jobitjoseph/USB-C-Power-Meter/Hardware/production/bom.csv

Designator | Footprint | Quantity | Value | LCSC Part #
C1, C2, C3, C4, C7, C8, C9 | 0402 | 7 | 100nF
C10, C11 | 0603 | 2 | 4.7uF
C5, C6 | 0402 | 2 | 1uF
J1 | USB_C_Plug_Molex_105444 | 1 | UP32-C-F-G-FL-1-P24 | C42453853
J2 | USB_C_Receptacle_HRO_TYPE-C-31-M-12 | 1 | USB_C_Receptacle_USB2.0_16P
Q1 | SOT-23 | 1 | SS8050
R1 | 0402 | 1 | 5.1K
R10, R11, R12, R13, R14, R15, R5, R6, R8 | 0402 | 9 | 10K
R2, R3, R7 | 0402 | 3 | 4.7K
R4 | 2512 | 1 | 10m
R9 | 0603 | 1 | 10R
SW1, SW2, SW3, SW4 | Untitled | 4 | ~
TP1, TP2, TP3, TP4, TP5 | TestPoint_Pad_D1.0mm | 5 | TestPoint_Small
U1 | VDFN10_9QX_MCH | 1 | PAC1811T-2E/9Q
U2 | SOT_223_5L_MCH | 1 | MCP1781-3302H/DB
U3 | OLED-SMD_ST7735S | 1 | N096-1608TBBIG11-H13
U4 | QFN48_7X7MC_MCH | 1 | ATSAMD21G18A-MFT
Y1 | Crystal_SMD_MicroCrystal_CM9V-T1A-2Pin_1.6x1.0mm_HandSoldering | 1 | 32.768KHz
