jobitjoseph/USB-C-Power-Meter/STL/Button.stl

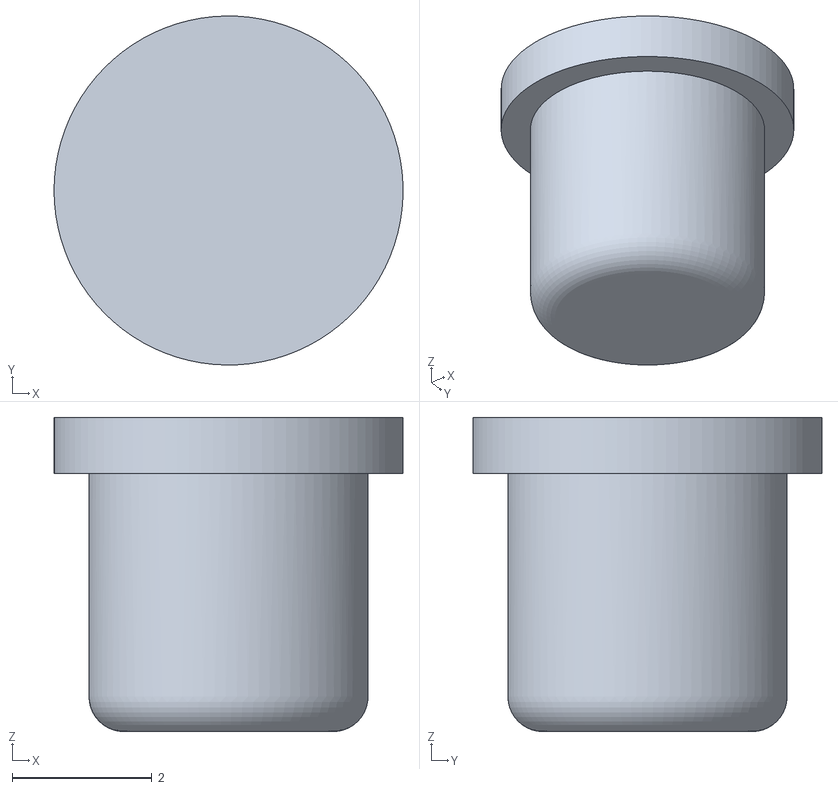
[picture p1: CAD file, 2026-10-21]
STL/Button.stl
5.00 x 5.00 x 4.50
