jobitjoseph/USB-C-Power-Meter/STL/Enclosure_Bottom.stl

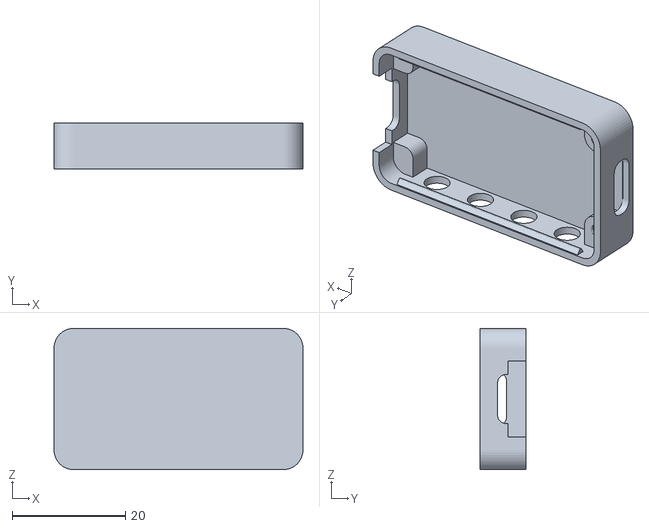
[picture p2: CAD file, 2026-10-21]
STL/Enclosure_Bottom.stl
44.0 x 8.09 x 25.0
