jobitjoseph/USB-C-Power-Meter/STL/Enclosure_Top.stl

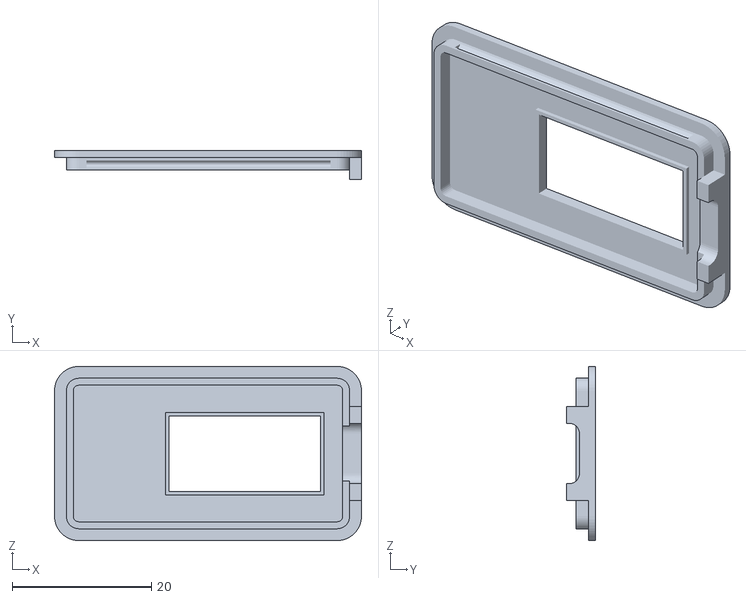
[picture p3: CAD file, 2026-10-21]
STL/Enclosure_Top.stl
44.0 x 4.15 x 25.0
