jobitjoseph/USB-C-Power-Meter/Hardware/USB-C_Power_Meter.pdf

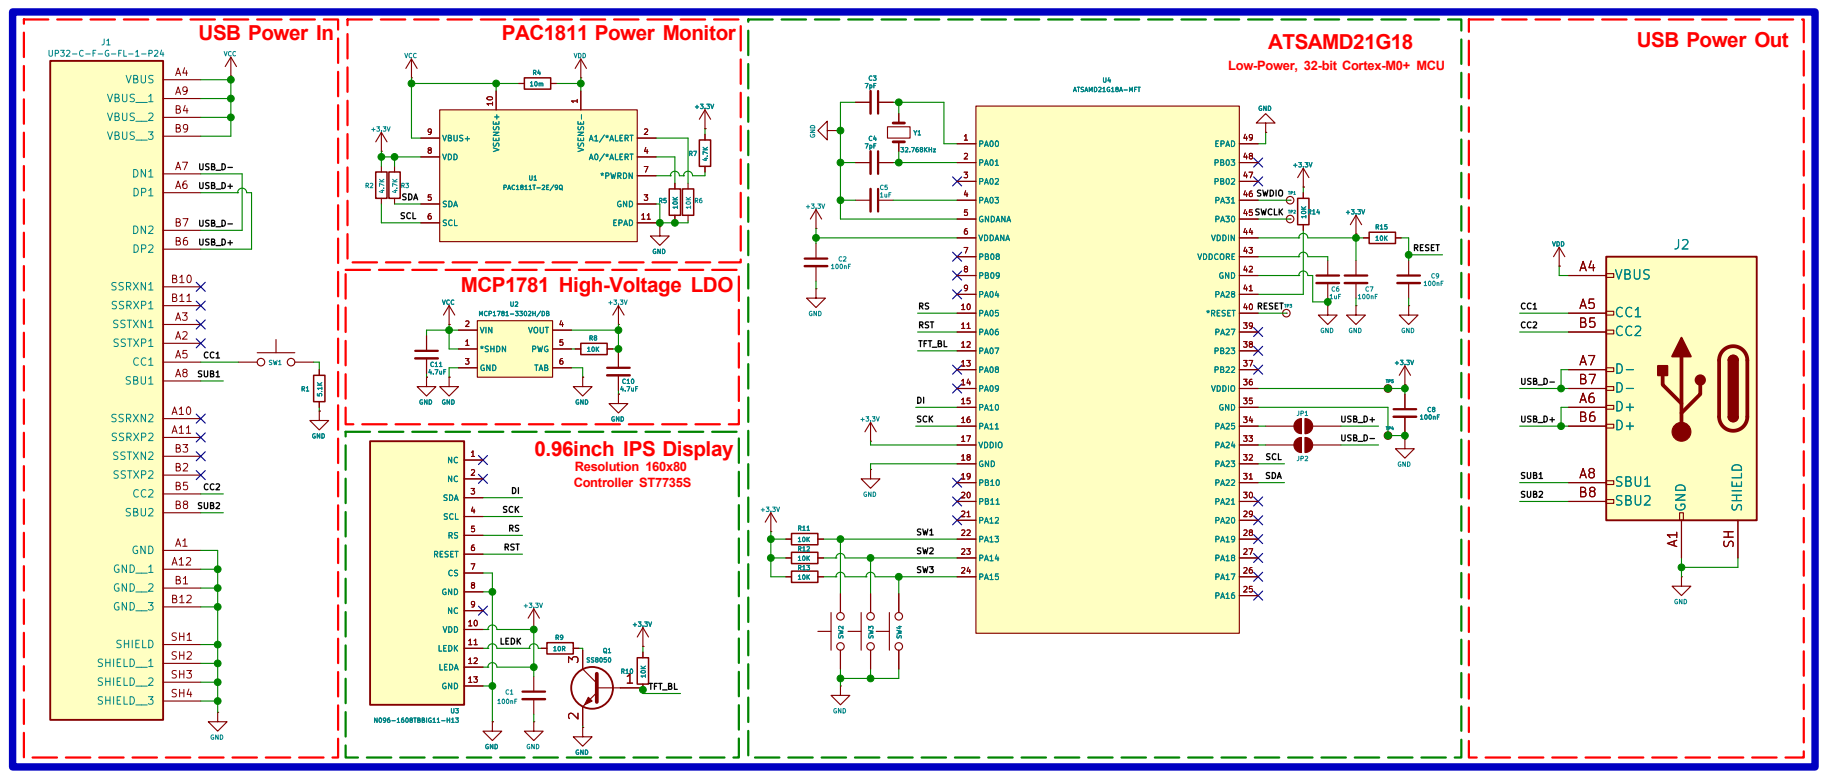
[picture p4: page 1]

Low-Power, 32-bit Cortex-M0+ MCU
