jobitjoseph/USB-C-Power-Meter/Hardware/USB-C_Power_Meter.kicad_pcb

## KiCad design Hardware/USB-C_Power_Meter.kicad_pcb (2026-10-21)

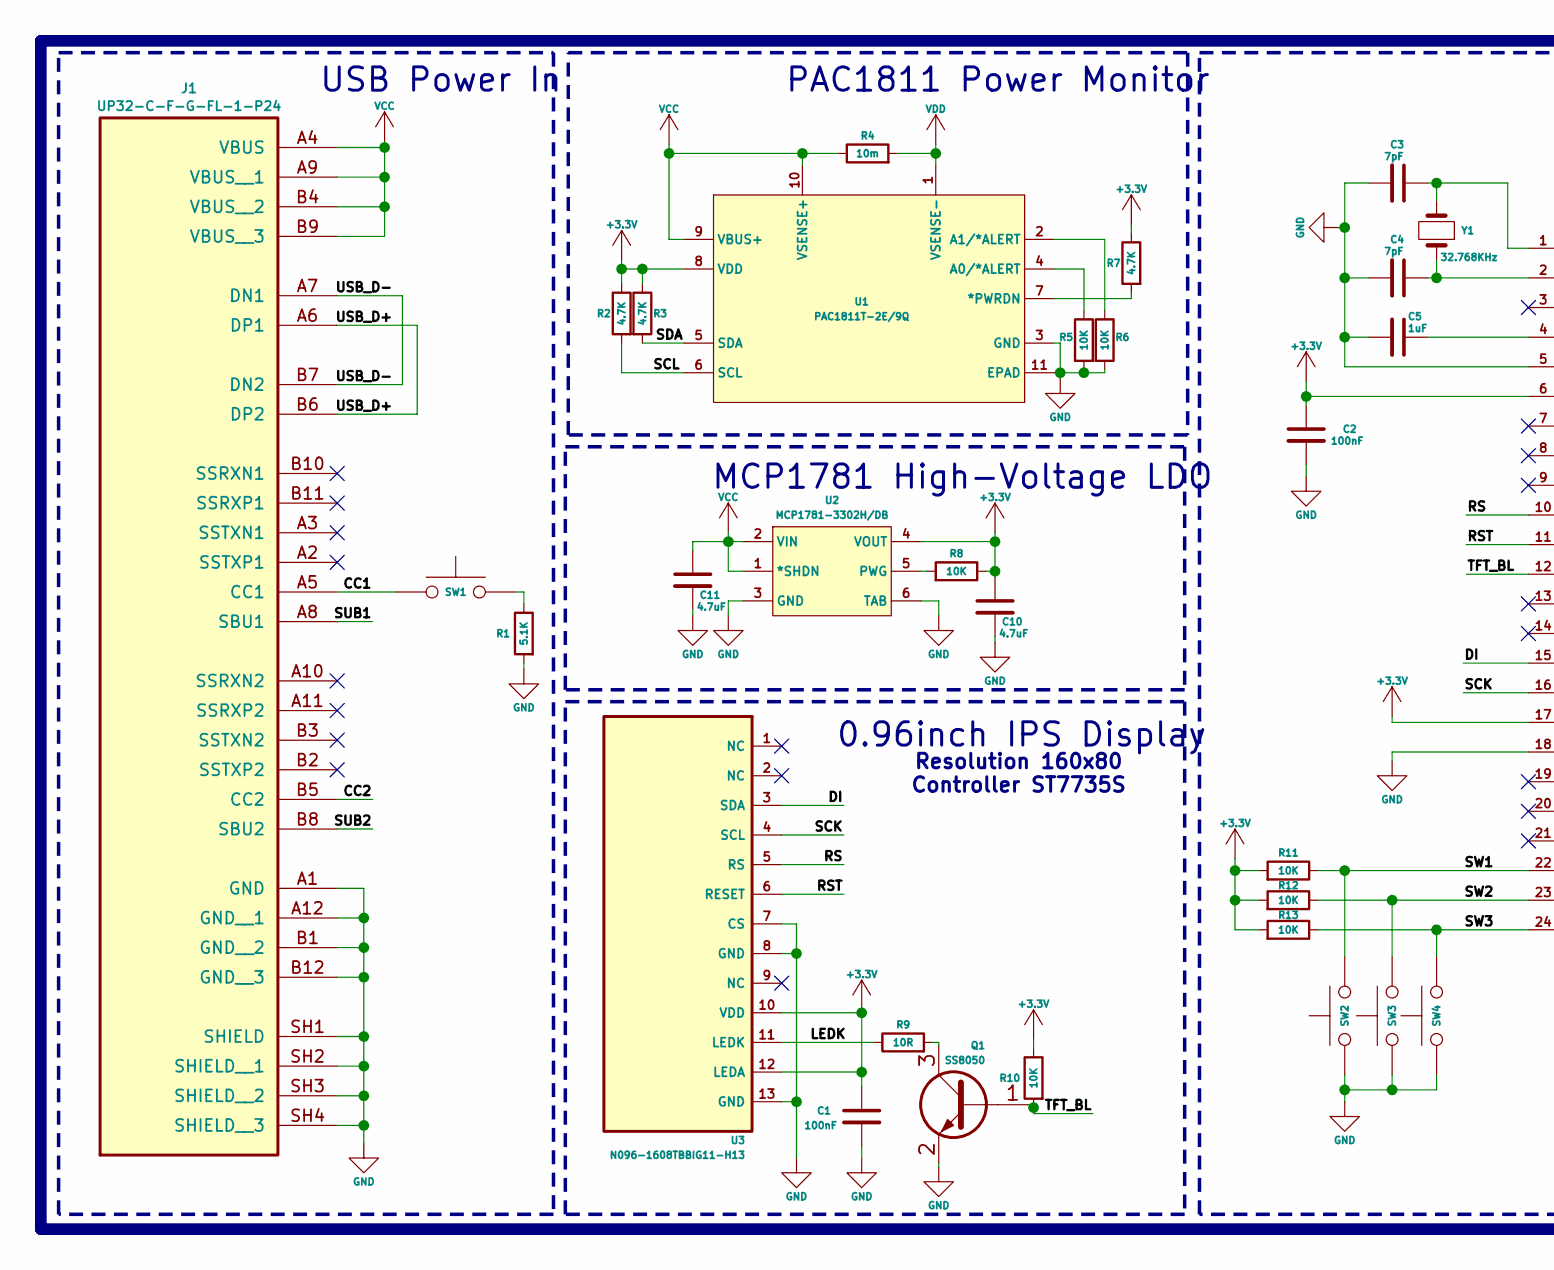
[picture p5: schematic USB-C_Power_Meter.kicad_sch, USB C Power Meter, part in row 1, column 1]

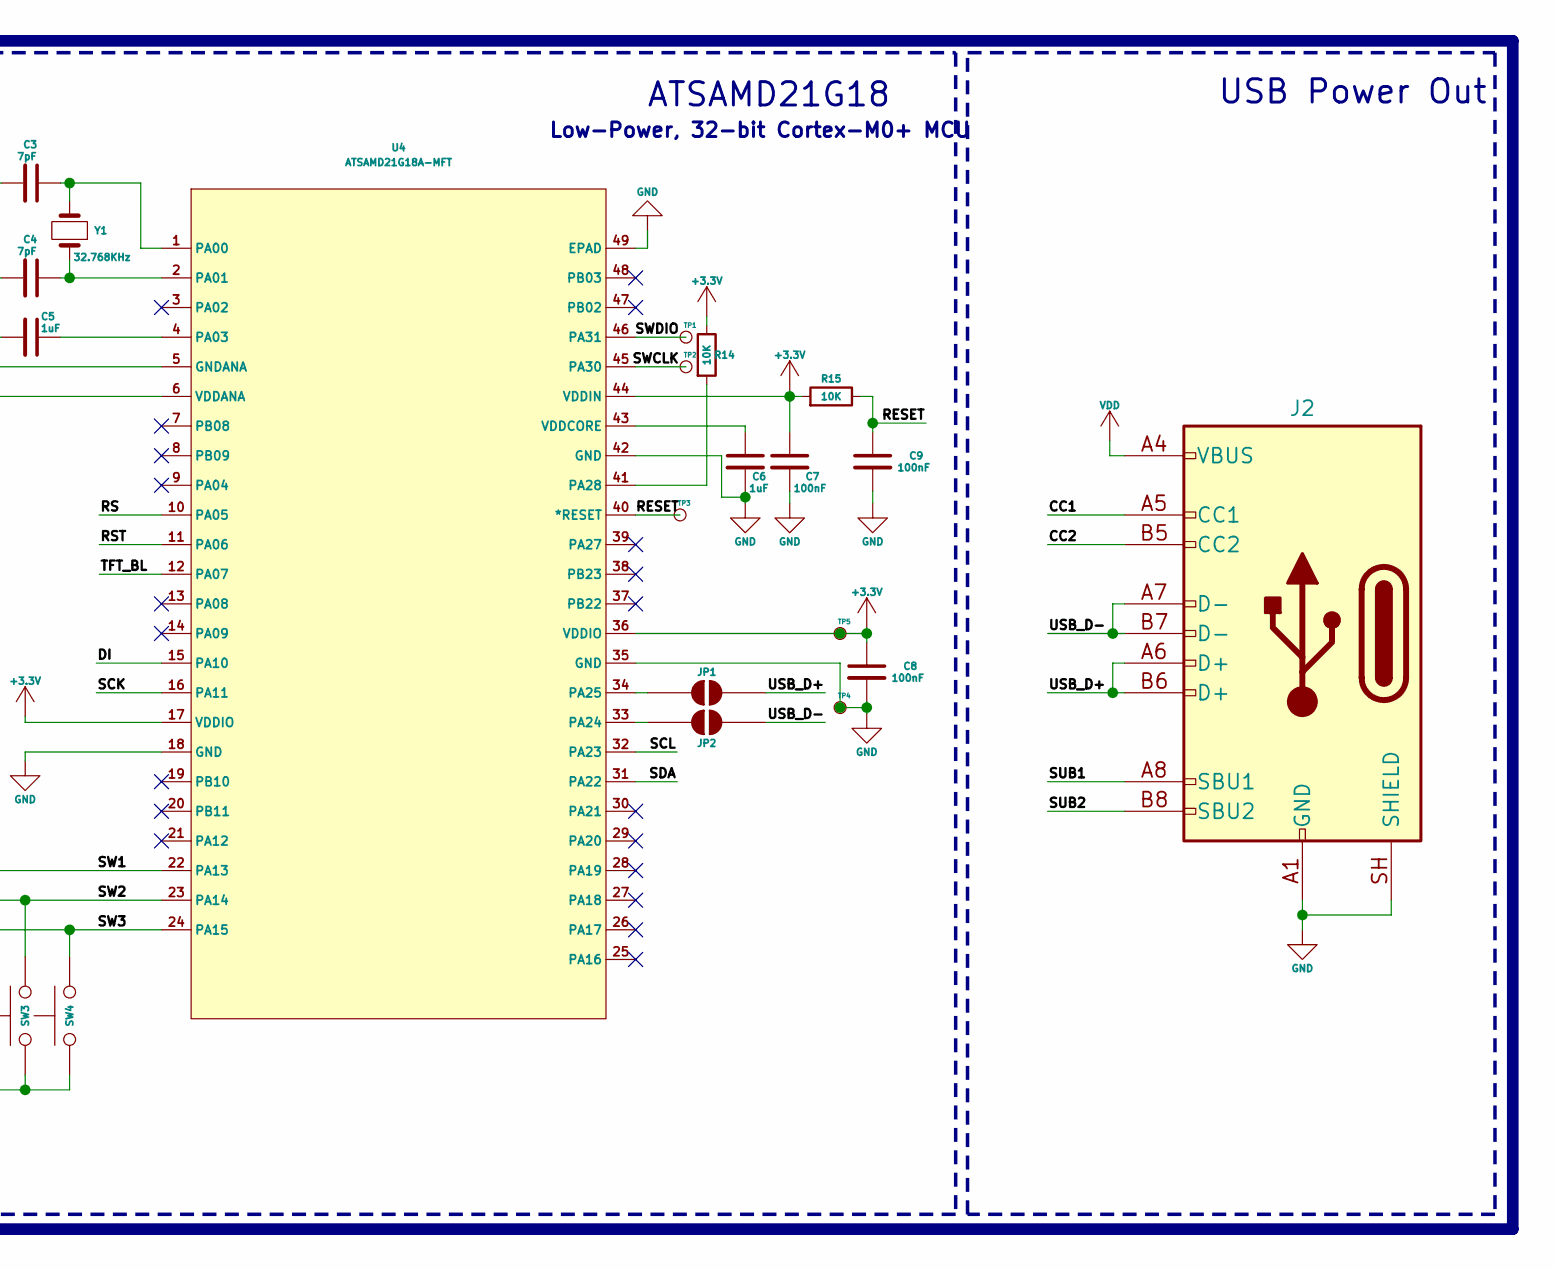
[picture p6: schematic USB-C_Power_Meter.kicad_sch, USB C Power Meter, part in row 1, column 2]

Parts:
C1, C2, C7, C8, C9: 100nF; C_0402_1005Metric
C3, C4: 7pF; C_0402_1005Metric
C5, C6: 1uF; C_0402_1005Metric
C10, C11: 4.7uF; C_0603_1608Metric
J1: UP32-C-F-G-FL-1-P24; USB_C_Plug_Molex_105444; PARTREV 1.01; LCSC Part # C42453853
J2: USB_C_Receptacle_USB2.0_16P; USB_C_Receptacle_HRO_TYPE-C-31-M-12
JP1, JP2: SolderJumper_2_Open; SolderJumper-2_P1.3mm_Open_TrianglePad1.0x1.5mm
Q1: SS8050; SOT-23
R1: 5.1K; R_0402_1005Metric
R2, R3, R7: 4.7K; R_0402_1005Metric
R4: 10m; R_2512_6332Metric
R5, R6, R8, R10, R11, R12, R13, R14, R15: 10K; R_0402_1005Metric
R9: 10R; R_0603_1608Metric
SW1, SW2, SW3, SW4: Untitled
TP1, TP2, TP3, TP4, TP5: TestPoint_Small; TestPoint_Pad_D1.0mm
U1: PAC1811T-2E/9Q; VDFN10_9QX_MCH
U2: MCP1781-3302H/DB; SOT_223_5L_MCH
U3: N096-1608TBBIG11-H13; OLED-SMD_ST7735S; Manufacturer Part N096-1608TBBIG11-H13; LCSC Part Name 0.96寸 13PIN TFT显示模块
U4: ATSAMD21G18A-MFT; QFN48_7X7MC_MCH
Y1: 32.768KHz; Crystal_SMD_MicroCrystal_CM9V-T1A-2Pin_1.6x1.0mm_HandSolder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

Connections:
+3.3V: C1.1, C2.1, C7.1, C8.1, C10.1, R2.2, R3.2, R7.2, R8.2, R10.2, R11.1, R12.1, R13.1, R14.2, R15.1, TP5.1 (1_1), U1.8 (VDD), U2.4 (VOUT), U3.10 (VDD), U3.12 (LEDA), U4.6 (VDDANA), U4.17 (VDDIO), U4.36 (VDDIO), U4.44 (VDDIN)
/CC1: J1.A5 (CC1), J2.A5 (CC1), SW1.1
/CC2: J1.B5 (CC2), J2.B5 (CC2)
/DI: U3.3 (SDA), U4.15 (PA10)
/LEDK: R9.2, U3.11 (LEDK)
/RESET: C9.1, R15.2, TP3.1 (1_1), U4.40 (*RESET)
/RS: U3.5 (RS), U4.10 (PA05)
/RST: U3.6 (RESET), U4.11 (PA06)
/SCK: U3.4 (SCL), U4.16 (PA11)
/SCL: R2.1, U1.6 (SCL), U4.32 (PA23)
/SDA: R3.1, U1.5 (SDA), U4.31 (PA22)
/SUB1: J1.A8 (SBU1), J2.A8 (SBU1)
/SUB2: J1.B8 (SBU2), J2.B8 (SBU2)
/SW1: R11.2, SW2.2, U4.22 (PA13)
/SW2: R12.2, SW3.2, U4.23 (PA14)
/SW3: R13.2, SW4.1, U4.24 (PA15)
/SWCLK: TP2.1 (1_1), U4.45 (PA30)
/SWDIO: TP1.1 (1_1), U4.46 (PA31)
/TFT_BL: Q1.1 (B), R10.1, U4.12 (PA07)
/USB_D+: J1.A6 (DP1), J1.B6 (DP2), J2.A6 (D+), J2.B6 (D+), JP1.2 (B)
/USB_D-: J1.A7 (DN1), J1.B7 (DN2), J2.A7 (D-), J2.B7 (D-), JP2.2 (B)
GND: C1.2, C2.2, C3.2, C4.2, C5.2, C6.2, C7.2, C8.2, C9.2, C10.2, C11.2, J1.A1 (GND), J1.A12 (GND__1), J1.B1 (GND__2), J1.B12 (GND__3), J1.SH, J1.SH1 (SHIELD), J1.SH2 (SHIELD__1), J1.SH3 (SHIELD__2), J1.SH4 (SHIELD__3), J2.A1 (GND), J2.A12 (GND), J2.B1 (GND), J2.B12 (GND), J2.SH (SHIELD), Q1.2 (E), R1.1, R5.1, R6.1, SW2.1, SW3.1, SW4.2, TP4.1 (1_1), U1.3 (GND), U1.11 (EPAD), U2.3 (GND), U2.6 (TAB), U3.7 (CS), U3.8 (GND), U3.13 (GND), U4.5 (GNDANA), U4.18 (GND), U4.35 (GND), U4.42 (GND), U4.49 (EPAD)
unnamed: JP1.1 (A), U4.34 (PA25)
unnamed: JP2.1 (A), U4.33 (PA24)
unnamed: Q1.3 (C), R9.1
unnamed: R1.2, SW1.2
unnamed: R7.1, U1.7 (*PWRDN)
unnamed: R5.2, U1.4 (A0/*ALERT)
unnamed: R6.2, U1.2 (A1/*ALERT)
unnamed: R8.1, U2.5 (PWG)
unnamed: C3.1, U4.1 (PA00), Y1.2
unnamed: C4.1, U4.2 (PA01), Y1.1
unnamed: C5.1, U4.4 (PA03)
unnamed: R14.1, U4.41 (PA28)
unnamed: C6.1, U4.43 (VDDCORE)
VCC: C11.1, J1.A4 (VBUS), J1.A9 (VBUS__1), J1.B4 (VBUS__2), J1.B9 (VBUS__3), R4.2, U1.9 (VBUS+), U1.10 (VSENSE+), U2.1 (*SHDN), U2.2 (VIN)
VDD: J2.A4 (VBUS), J2.A9 (VBUS), J2.B4 (VBUS), J2.B9 (VBUS), R4.1, U1.1 (VSENSE-)

Notes on the sheet:
ATSAMD21G18
PAC1811 Power Monitor
Resolution 160x80 Controller ST7735S
Low-Power, 32-bit Cortex-M0+ MCU
USB Power In
MCP1781 High-Voltage LDO
0.96inch IPS Display
USB Power Out

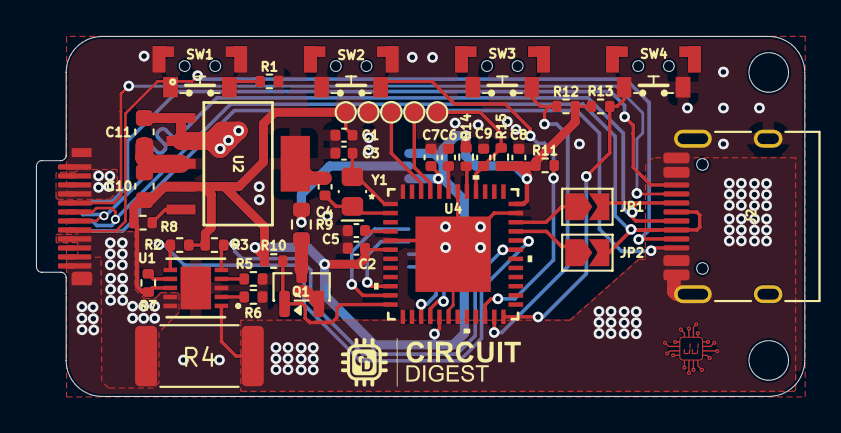
[picture p7: board USB-C_Power_Meter.kicad_pcb from above]

Board: 4 copper layers, 42.7 x 20.0 mm, 45 parts (1 on the bottom side), 37 nets.
